ekuinox/mube/docs/superpowers/specs/2026-06-30-usb-power-5v3a-design.md

# #23 USB 電源を 5V/3A 化（M-12001 採用）設計

- Issue: #23 C2 5V/1A USB 電源がサーボ失速時に不足する可能性（親 #12）
- 日付: 2026-06-30
- 種別: ドキュメント変更のみ

## 背景

5V/1A の USB AC アダプタ（M-08312）では、サーボ失速時に電流が不足する恐れがある。

| 負荷 | 電流 |
| --- | --- |
| Pico W（WiFi active） | 100-200mA |
| SG90 サーボ（失速） | 650-700mA |
| LED（330R, 3.3V） | 4mA |
| 合計 | 約 900mA（1A に迫る） |

サムターンが固い場合や突入電流を考えると 1A では足りない。`docs/parts-selection.md` に代替として記載済みの 5V/3A（M-12001）へ切り替える。

## 変更範囲

`docs/parts-selection.md` のみ。`circuit/netlist.py`・ファーム・筐体は変更しない。AC アダプタとケーブルは基板部品ではなく netlist 管理外（メイン表の手配線品目）であり、netlist の PARTS/BOM には現れないため。

ビルド・テストへの影響なし。検証は表の金額合計・品目数の算術整合の目視確認のみ。

## 決定事項

- 案 A 採用: M-12001（Micro-B オス直結 5V/3A ¥1,100）をメイン表へ昇格。Micro-USB 端子へ直結できるため、micro-USB ケーブル（C-09314 ¥150）は不要となり BOM から削除する。
- 旧 5V/1A 品（M-08312）はメイン表・代替候補とも完全削除する。issue の結論が「1A は不足」と明確なため、候補に残さない。
- 「USB AC アダプタは 5V/1A 以上」の注意書きは「5V/3A 推奨（最低でも 5V/2A 以上）」へ更新する。

## 具体的な編集（`docs/parts-selection.md`）

1. 概要（範囲・購入先・在庫）の品目数を 17 → 16、手配線追加を 6 → 5、代替候補 4 → 3 に更新。
2. メイン表: USB 電源行を M-08312 → M-12001（¥1,100）へ置換。micro-USB ケーブル行（C-09314）を削除。
3. 概算サマリ:
   - ① 理論按分合計 ¥3,274 → ¥3,454
   - ② 実支出 ¥4,425 → ¥4,605
   - 内訳の秋月合計も ¥4,605 に更新
4. 購入先まとめ: M-08312 行を M-12001 行に差し替え、C-09314 行を削除。集約率 17/17 → 16/16。
5. 代替候補: M-12001 のエントリを削除（メイン昇格のため）。
6. 注意点:
   - 「USB AC アダプタは 5V/1A 以上」→「5V/3A 推奨（最低でも 5V/2A 以上）。サーボ失速電流 650-700mA に Pico W(WiFi) と LED を加えると 1A に迫るため」。
   - 「Pico W の USB コネクタは Micro-USB B。品目 14 のケーブルが対応していることを確認」→ M-12001 が Micro-B オス直結である旨に更新（ケーブルは無くなったため）。

## 金額の検算

新 ① = 1240+650+140+2+1+4+15+15+10+130+35+70+1100+12+10+20 = ¥3,454。
新 ② = 1240+650+140+150+100+180+150+15+10+130+350+70+1100+120+100+100 = ¥4,605。
旧との差分はいずれも -770-150+1100 = +180 で一致。

## 兄弟イシューとの兼ね合い

#21/#25/#26 は master（0a218c4）でマージ済みのため、本変更はその上に乗せる。同じ BOM 表を触る後続作業はない想定。
