ekuinox/mube/backlog/tasks/task-3 - detect-thumbturn-position-with-a-magnetic-sensor.md

---
id: TASK-3
title: サムターンの向き（施錠/解錠）を磁気センサーで取得する
status: To Do
assignee: []
created_date: '2026-07-20 09:44'
updated_date: '2026-07-20 09:58'
labels:
  - firmware
  - circuit
  - scad
dependencies: []
ordinal: 3000
---

## Description

<!-- SECTION:DESCRIPTION:BEGIN -->
サムターンの物理的な向き（施錠位置か解錠位置か）を実物のセンサーで取得する。現状のファームは指令値としての LockState しか持っておらず、実際にサムターンがどちらを向いているかは検知していない。位置センサーを足して、指令と実物のズレを解消する。方式の検討結果と評価候補パーツの記録。実装方式は実機評価で 1 つに確定させる前提で、まだ確定しない。（GitHub issue #67 から移管）

## 目的

- 手動操作の検知: 人が手でサムターンを回したことをファームが気づき、内部の状態を実物に追従させる。
- サーボ動作の確認: サーボが本当に施錠／解錠位置まで回りきったかを実測でフィードバックする（空振り・脱調の検知）。

連続角度は不要で、施錠／解錠の 2 値（＋どちらでもない中間）が分かれば十分。

## 方式

回転する側（サーボホーン／ソケット）に磁石を付け、動かない筐体側に磁気の位置センサーを置いて 2 値を読む。連続角度を取る AS5600 のようなロータリーエンコーダや、リニアホール＋ADC はオーバースペックのため見送る。

## 評価候補パーツ（秋月・両方買って実機比較する）

手はんだ前提で表面実装（SMD）は避ける、秋月で在庫がある、という制約で残った 2 つ。どちらもスルーホールで合計 350 円程度と安いので、ブレッドボードで両方組んで実測してから採用を決める。

| 素子 | 商品名 | 通販コード | 価格 | 構成 |
| --- | --- | --- | --- | --- |
| ホールラッチIC | SK1816G-G03（SIP-3, 交番検知, Bop +5mT / Brp -5mT） | I-11027 | 30円/個 | センサー1個＋逆向き磁石2個で1ビット取得 |
| リードスイッチ | MKA-10110（A接点, 無極性, ガラス管 φ1.8×10mm） | P-03676 | 290円/5個入 | センサー2個＋磁石1個 |

磁石は秋月に手頃な小型ネオジムの安定した商品が見当たらないため別調達（100均やモノタロウ等）。ラッチ式は感度しきい値 5mT が精密な代わりに極性と向きがシビア、リード式は当たりが広く極性・向き自由な代わりに動作点のバラつきが大きめ。動作ギャップはどちらも磁石の強さで決まり、数 mm のギャップなら両方とも届く見込み。

磁石の材質はネオジム必須ではない。ホールラッチのしきい値は 5mT と低く、リードも感度が良いため、100均のフェライト磁石でも数 mm の近距離なら反応する見込み。ネオジムの利点は同サイズで磁界が強くギャップを稼げる点にとどまる。材質より形と極の付き方が重要で、片面が N・反対面が S の固いボタン型／円盤／棒磁石なら可、冷蔵庫用のゴムシート型（多極着磁）は近距離で磁界が打ち消し合うため不可。ラッチ式で使う場合はどちらの面が N/S かの把握が必要（施錠位置に S 面・解錠位置に N 面の逆向き 2 個配置のため）。リード式は向き自由。まずは手持ちの磁石を実ギャップの距離で近づけてトリップするか確認するのが最短。

## 2方式の違いとトレードオフ

- ラッチ式（SK1816G ×1＋磁石2個）: 施錠位置に S 極、解錠位置に N 極を外向きに置き、固定した 1 個のセンサーで S極→ON・N極→OFF を読む。ソリッドステートで小型・精密・安価、GPIO 1 本で済む。欠点は、ラッチが最後に到達した位置を保持する仕組みのため「今まさに途中（半開き）」をリアルタイムに出せないことと、逆向き磁石 2 個の配置がシビアなこと。
- リード式（MKA-10110 ×2＋磁石1個）: 施錠角度と解錠角度にリードを 1 個ずつ置く。既存のタクトスイッチ SW1 と同じく片足を GPIO＋内部プルアップ、片足を GND に落とすだけで配線が最も単純。両方 OFF で中間（半開き）を明示的に検出でき、磁石は向き自由で 1 個。欠点はガラス管で割れやすく大きめ、接点のチャタリングにデバウンスが要ること（SW1 と同じ対処でよい）。

## 検討で見送ったもの（記録）

- ユニポーラ（非ラッチ）のホールIC S-5716ACDH0-M3T1U（I-16180）: 特性は理想的だが SOT23-3 の SMD で手はんだが厳しい。DIP 化変換基板でも SOT23 を付ける所が SMD 作業のままで解決しない。
- スルーホールのユニポーラ品 SK8552G-G03（I-11029）: 理想的だが入荷未定で在庫切れ。復活すれば有力候補。
- スルーホールのラッチ品 UH277G-G04（I-11031）や SK1816G を素直な 2 センサー方式で使うのは不可。ラッチは磁石が離れても OFF に戻らず、両方 ON で固まって区別できなくなる。ラッチは 1 センサー＋逆向き磁石 2 個の構成で使う。

## 実機で詰める未確定事項

- 磁石の種類・サイズと、ロータとセンサーのギャップ。
- センサー取付角度（施錠と解錠は約 90 度想定）と、施錠側と解錠側が互いに干渉しない離隔。
- GPIO 割当（暫定 GP19 / GP20）とデバウンス時定数。リード式は 2 本、ラッチ式は 1 本。
- 機構側の磁石マウントとセンサー座は採寸依存のため socket / mount_plate 側の未確定値として隔離する。

## 想定する影響範囲（実装時）

- circuit: `circuit/parts.ts` にセンサーとネットを追加、ERC とブレッドボード図を更新。
- mube-core: 物理位置の状態を追加し、指令 LockState と突き合わせて手回し検知とサーボ確認を行う。host テストを追加。
- firmware: 入力ピンをデバウンス付きで読む処理を追加（SW1 のボタン処理を流用）。
- プロトコル: STATUS 応答に物理位置を追加。
- scad: 磁石マウントとセンサー座（採寸確定後）。
<!-- SECTION:DESCRIPTION:END -->

## Acceptance Criteria
<!-- AC:BEGIN -->
- [ ] #1 実ギャップで確実にトリップ／リリースする
- [ ] #2 施錠位置と解錠位置を誤りなく区別できる（隣のセンサーや磁石の干渉がない）
- [ ] #3 手動操作の検知とサーボ到達の確認が意図通り動く
- [ ] #4 ラッチ式採用時、中間状態を出せない件が運用上問題ないことを確認
<!-- AC:END -->

## Implementation Notes

<!-- SECTION:NOTES:BEGIN -->
TASK-2（手回し操作後の施錠状態の再同期）を統合。位置センサーで実位置を取得できれば、手回し検知と内部状態の再同期はこのタスクの目的そのもの。
<!-- SECTION:NOTES:END -->
