ekuinox/mube/backlog/tasks/task-6 - top-heavy-mount-peels-off.md

---
id: TASK-6
title: 本体上部が重く固定が上から剥がれてくる
status: To Do
assignee: []
created_date: '2026-07-20 10:46'
labels:
  - scad
dependencies: []
ordinal: 6000
---

## Description

<!-- SECTION:DESCRIPTION:BEGIN -->
本体の上部が重く、ドアへ貼り付けた固定が上から剥がれてくる。現状の貼り付け（両面テープ想定）では、重心が高いぶんモーメントがかかって剥離しやすい。おそらくより強力な両面テープに替えても同じことが起こりうる。

検討したいこと:
- 重心を下げる（重量物＝サーボ／基板／電源の配置を下側へ寄せる、筐体の高さ・張り出しを減らす）
- 固定方法の見直し（貼り付け面積の拡大、ネジ／ブラケット併用、サムターン軸まわりでの支持）
- ドア側の受け構造で上方向の剥離モーメントを受け止める

関連: `scad/` の筐体レイアウトと取り付け方式。
<!-- SECTION:DESCRIPTION:END -->

## Acceptance Criteria
<!-- AC:BEGIN -->
- [ ] #1 重心を下げる／固定方法を見直して、上方向の剥離で外れないようにする
- [ ] #2 両面テープ以外も含めた固定方式の候補を比較検討する
<!-- AC:END -->
