ekuinox/mube/docs/parts-selection.md

# スマートロック パーツ選定（調達ドキュメント）

## 概要

- 目的: 回路記述（`circuit/index.tsx`、tscircuit）の部品を日本のネット通販で発注できる実商品へ対応づけ、購入先をまとめて 1 台分の概算を出す。
- 範囲: 完成実機に物理的に残る全 16 品目（BOM 11 点＋手配線に要る追加 5 点）。道具・消耗品は対象外。
- 購入先方針: 秋月電子通商に集約。全 16 品目が秋月で揃う。
- 調査日: 2026-06-25（価格・在庫・通販コードはこの時点のスナップショット。変動するため発注前に各店で要確認）。通販コードは各商品ページへのリンクになっている。
- 在庫・販売状況: 2026-06-25 時点で、メイン表 16 品目および備考の代替候補 3 品目すべてが秋月電子で販売中・在庫ありであることを商品ページで確認済み（廃盤なし）。一部は次回入荷待ちの表記があるが注文は可能。追加 3 品目（C2, D2, M2ネジ）は 2026-06-30 時点で在庫確認済み。USB 電源 M-12001 は 2026-06-30 時点で在庫確認済み。
- 数量: スマートロック 1 台分。パック品はパック価格と 1 台按分額を併記。

## メイン表

| Ref/品目 | 商品名 | 店 | 通販コード | 商品単価(税込) | 入数 | 1台必要数 | 1台按分額 |
|---|---|----|---|---|---|---|---|
| U1 Pico W | Raspberry Pi Pico W | 秋月 | [M-17947](https://akizukidenshi.com/catalog/g/g117947/) | ¥1,240 | 1 | 1 | ¥1,240 |
| M1 SG90 | マイクロサーボ9g SG90 | 秋月 | [M-08761](https://akizukidenshi.com/catalog/g/g108761/) | ¥650 | 1 | 1 | ¥650 |
| Q1 FET | NchパワーMOSFET 30V260A IRLB3813PBF | 秋月 | [I-06270](https://akizukidenshi.com/catalog/g/g106270/) | ¥140 | 1 | 1 | ¥140 |
| Rg 220Ω | カーボン抵抗(炭素皮膜抵抗) 1/4W220Ω | 秋月 | [R-25221](https://akizukidenshi.com/catalog/g/g125221/) | ¥150 | 100 | 1 | ¥2 |
| Rgs 10kΩ | カーボン抵抗(炭素皮膜抵抗) 1/4W10kΩ | 秋月 | [R-25103](https://akizukidenshi.com/catalog/g/g125103/) | ¥100 | 100 | 1 | ¥1 |
| Rled 330Ω | カーボン抵抗(炭素皮膜抵抗) 1/4W330Ω | 秋月 | [R-25331](https://akizukidenshi.com/catalog/g/g125331/) | ¥180 | 100 | 2 | ¥4 |
| D1 2色LED | 2色LED 赤・黄緑5mm カソードコモン 乳白色 OSRGHC5B32A（10個入） | 秋月 | [I-06314](https://akizukidenshi.com/catalog/g/g106314/) | ¥150 | 10 | 1 | ¥15 |
| SW1 押しボタン | パネル用押しボタンスイッチ モーメンタリー 丸型 白 PS21B-1 | 秋月 | [P-04583](https://akizukidenshi.com/catalog/g/g104583/) | ¥160 | 1 | 1 | ¥160 |
| C1 470µF | 電解コンデンサー 470µF16V105℃ ルビコンPX | 秋月 | [P-10273](https://akizukidenshi.com/catalog/g/g110273/) | ¥10 | 1 | 1 | ¥10 |
| - ユニバーサル基板 | 片面ガラスコンポジット・ユニバーサル基板 Cタイプ(72×47mm) めっき仕上げ | 秋月 | [P-03229](https://akizukidenshi.com/catalog/g/g103229/) | ¥130 | 1 | 1 | ¥130 |
| - 配線材 | 耐熱電子ワイヤー 1m×10色 導体外径0.36mm(AWG28相当) | 秋月 | [P-11640](https://akizukidenshi.com/catalog/g/g111640/) | ¥350 | 10 | 1 | ¥35 |
| - ピンヘッダ | ピンヘッダー 1×40 (40P) | 秋月 | [C-00167](https://akizukidenshi.com/catalog/g/g100167/) | ¥35 | 1 | 2 | ¥70 |
| - USB電源 | USB ACアダプター Micro-Bオス直結 5V3A | 秋月 | [M-12001](https://akizukidenshi.com/catalog/g/g112001/) | ¥1,100 | 1 | 1 | ¥1,100 |
| C2 100nF | 積層セラミックコンデンサー 0.1µF100V X7R 5mmピッチ | 秋月 | [P-15927](https://akizukidenshi.com/catalog/g/g115927/) | ¥120 | 10 | 1 | ¥12 |
| D2 1N5819 | ショットキーバリアダイオード 40V1A 1N5819 | 秋月 | [I-17244](https://akizukidenshi.com/catalog/g/g117244/) | ¥100 | 10 | 1 | ¥10 |
| - M2ネジ (サーボ固定) | なべ小ねじ(+) M2×5 黄銅 | 秋月 | [P-15887](https://akizukidenshi.com/catalog/g/g115887/) | ¥100 | 10 | 2 | ¥20 |

## 概算サマリ

- ① 1台分の理論按分合計: ¥3,599（按分額列の総和。理論上 1 台が消費する分だけの価値）
- ② 実際に 1 台作るために払う総額: ¥4,750（パック品も丸ごと買う前提の実支出。送料別）
  - 内訳: 秋月 ¥4,750（全点秋月、他店送りなし）
  - 送料の目安: 秋月電子は注文金額により変動。発注前に各店の送料条件を確認。
- 補足: ②は初回 1 台の実支出。抵抗等のパック余剰（各 99 本残）により 2 台目以降は①に近づく。

## 購入先まとめ

秋月電子通商で全点購入（集約率 16/16 = 100%）。他店送りなし。

| 店 | 通販コード | 品目 |
|----|---|---|
| 秋月電子通商 | [M-17947](https://akizukidenshi.com/catalog/g/g117947/) | Raspberry Pi Pico W |
| 秋月電子通商 | [M-08761](https://akizukidenshi.com/catalog/g/g108761/) | マイクロサーボ9g SG90 |
| 秋月電子通商 | [I-06270](https://akizukidenshi.com/catalog/g/g106270/) | NchパワーMOSFET IRLB3813PBF |
| 秋月電子通商 | [R-25221](https://akizukidenshi.com/catalog/g/g125221/) | カーボン抵抗 1/4W 220Ω（100本入） |
| 秋月電子通商 | [R-25103](https://akizukidenshi.com/catalog/g/g125103/) | カーボン抵抗 1/4W 10kΩ（100本入） |
| 秋月電子通商 | [R-25331](https://akizukidenshi.com/catalog/g/g125331/) | カーボン抵抗 1/4W 330Ω（100本入, 2本使用） |
| 秋月電子通商 | [I-06314](https://akizukidenshi.com/catalog/g/g106314/) | 2色LED 赤・黄緑 5mm カソードコモン 乳白色 OSRGHC5B32A（10個入） |
| 秋月電子通商 | [P-04583](https://akizukidenshi.com/catalog/g/g104583/) | パネル用押しボタンスイッチ モーメンタリー 丸型 白 PS21B-1 |
| 秋月電子通商 | [P-10273](https://akizukidenshi.com/catalog/g/g110273/) | 電解コンデンサー 470µF16V |
| 秋月電子通商 | [P-03229](https://akizukidenshi.com/catalog/g/g103229/) | 片面ユニバーサル基板 Cタイプ(72×47mm) めっき仕上げ |
| 秋月電子通商 | [P-11640](https://akizukidenshi.com/catalog/g/g111640/) | 耐熱電子ワイヤー 1m×10色 AWG28 |
| 秋月電子通商 | [C-00167](https://akizukidenshi.com/catalog/g/g100167/) | ピンヘッダー 1×40 ×2本 |
| 秋月電子通商 | [M-12001](https://akizukidenshi.com/catalog/g/g112001/) | USB ACアダプター Micro-Bオス直結 5V3A |
| 秋月電子通商 | [P-15927](https://akizukidenshi.com/catalog/g/g115927/) | 積層セラミックコンデンサー 0.1µF100V X7R 5mmピッチ（10個入, 1個使用） |
| 秋月電子通商 | [I-17244](https://akizukidenshi.com/catalog/g/g117244/) | ショットキーバリアダイオード 40V1A 1N5819（10本入, 1本使用） |
| 秋月電子通商 | [P-15887](https://akizukidenshi.com/catalog/g/g115887/) | なべ小ねじ(+) M2×5 黄銅（10個入, 2個使用） |

## 備考

### MOSFET の注意（重要）

第一候補の IRLZ44N は秋月取扱なしのため、採用品は IRLB3813PBF（秋月 I-06270, N-ch 30V/260A）。Q1 はサーボの GND リターン（SERVO_RTN）を切るローサイドスイッチで、ゲートは Pico W の GP14（3.3V）から Rg(220Ω) 経由で駆動し Rgs(10k) でプルダウン、給電時のみ ON のワンショット（約 500ms）。

**3.3V ゲート駆動の評価（現状維持の根拠, Issue #24）**

データシート実値（Infineon IRLB3813）: Vgs(th) min 1.35V / typ 1.9V / max 2.35V、Rds(on) @ Vgs=4.5V = 2.6mΩ(max)、@ Vgs=10V = 1.95mΩ(max)。3.3V GPIO で十分オンする直接的な根拠は Vgs(th) max 2.35V < 3.3V（GPIO 電圧が最悪閾値を上回る）であり、Rds(on) が Vgs=4.5V で規定されていることは本品がロジックレベル MOSFET であることの補強である。

- 十分にオンする: Vgs=3.3V のゲートオーバードライブは typ 閾値 1.9V に対し約 1.4V、最悪の閾値 max 2.35V でも約 0.95V。3.3V でエンハンスメント領域に入る。
- 電圧降下は無視できる: 3.3V は Rds(on) 規定点(4.5V)をわずかに下回るのみ。保守的に Rds(on) を Vgs=4.5V 時(2.6mΩ)の約 20 倍＝高々 50mΩ と見積もっても、SG90 の起動・失速ピーク（〜1A 程度）での降下は最悪約 50mV、実際は現実的な Rds(on)≒10mΩ 想定で 10mV 前後で、5V 供給に対し無視できる。
- 発熱も無視できる: ワンショット 500ms のため、ピーク電力は最悪でも P = I²·Rds(on) ≒ 1²×0.05 = 0.05W ≒ 50mW 程度、現実的な Rds(on)≒10mΩ 想定では約 10mW（1²×0.01）で問題にならない。

**実機ブリングアップ時の確認手順（受け入れ条件）**

1. サーボを動作させ、可能なら失速させてピーク電流を引かせる。
2. その状態で Q1 のドレイン-ソース間電圧 Vds を計測する。
3. 受け入れ基準: ピーク負荷で Vds ≤ 0.2V（5V 供給から実効サーボ電圧 ≥ 4.8V を確保、SG90 定格 4.8〜6V 内）。
4. 基準超過時: ロジックレベル品（Vgs(th) が低いスルーホール・秋月入手可の N-FET）への差し替え、または小信号トランジスタ等でゲートを 5V までスイングし Vgs≥4.5V を保証する 5V ゲート駆動の追加を検討する。

### 配線材

ジュンフロン線は秋月ネット通販で取扱なし。耐熱電子ワイヤー AWG28（[P-11640](https://akizukidenshi.com/catalog/g/g111640/)）で代替。手配線に十分。

### 代替候補

- Pico WH ヘッダ付き（[M-18086](https://akizukidenshi.com/catalog/g/g118086/) ¥1,375）: ピンヘッダ実装済みのため、ピンヘッダ（[C-00167](https://akizukidenshi.com/catalog/g/g100167/)）の購入が不要になる。
- 電解コンデンサ 25V 品（[P-17883](https://akizukidenshi.com/catalog/g/g117883/) ¥20）: 耐圧に余裕が欲しい場合の代替。
- ユニバーサル基板 eleshop UP-203GSR（[MA7128](https://eleshop.jp/shop/g/gMA7128/) ¥363, 両面, 既製四隅穴ピッチ 64×39）: 一度こちらへ変更したが（#68）、未使用のまま P-03229 に戻した。両面スルーホールが欲しい場合の代替。
- ユニバーサル基板 72×47.5mm（[P-00517](https://akizukidenshi.com/catalog/g/g100517/) ¥100）: 部品点数が増えた場合の代替。

### 注意点

- 二色LED（D1, OSRGHC5B32A）はコモンカソード。3 本足のうち共通カソード（K）を GND、赤アノード（R）を GP16、黄緑アノード（G）を GP18 へ。足の並びはデータシートで確認すること。赤・黄緑とも Vf=2.1V のため抵抗は両側 330Ω で明るさが揃う。施錠=赤・解錠=黄緑で点灯し、同時点灯はしない。
- 電解コンデンサ（C1）は極性あり。実装時に＋端子の向きを確認すること。耐圧 16V は VBUS 5V に対し十分な余裕がある。
- USB ACアダプタは 5V/3A 推奨（最低でも 5V/2A 以上）。サーボ失速電流 650-700mA に Pico W(WiFi) 100-200mA と LED を加えると 1A に迫り、5V/1A では突入・失速時に不足する恐れがあるため。
- Pico W の USB コネクタは Micro-USB B。採用した M-12001 は Micro-B オス直結なので、別途ケーブルなしで直接挿せる。
- セラミックコンデンサ（C2）は無極性。C1（電解 470µF）に並列で VBUS-GND 間に配置する。C1 に隣接させること（高周波バイパス効果のため）。
- ユニバーサル基板（P-03229）の既製の四隅マウント穴は φ3.2、中心間ピッチ 長辺66mm×短辺41mm。トレイはこの四隅穴に合わせた支柱 4 本で基板を受ける（M2 セルフタップ。φ3.2 に対しネジ山は効かず頭で押さえる）。
- ショットキーダイオード（D2, 1N5819）はカソード帯（白帯）を +5V 側（M1.V+）に、アノードを SERVO_RTN 側（M1.GND / Q1.D）に接続する。逆に付けるとサーボ電源が短絡するので極性に注意。
- M2 ネジ（なべ小ねじ M2×5）はサーボ耳のネジ穴 2 箇所に使用する。3D プリント筐体の 1.8mm パイロットホールにセルフタップで固定する。締めすぎるとボスが割れるので注意。
- SW1 は基板実装のタクトスイッチ（P-03647）からパネル取付の PS21B-1 へ変更した（2026-08-16）。カバー越しに押せるようにするため。実測値: ネジ部外径 φ11.5、フランジ φ18.7、パネル面より内側の奥行き 26mm。取付穴は φ12.0 で設計している。

### 回路記述（circuit/index.tsx）への申し送り TODO

実機で型番確定後に FET の value を 1 つへ絞り込み、コンデンサ耐圧を value に追記する。
