ekuinox/mube/docs/superpowers/specs/2026-06-30-bom-update-design.md

# BOM 3 品目追加 (closes #21, #25, #26)

## 背景

横断整合性レビュー (#12) で発見された以下 3 件を一括で対応する。

- #21 B6: M2 ネジが `parts-selection.md` の BOM に未記載
- #25 D1: セラミックバイパスコンデンサ (100nF) がない
- #26 D2: サーボモータにフライバックダイオードがない

## 追加部品

| 品目 | 商品名 | 通販コード | 単価(税込) | 入数 | 1台必要数 | 按分額 |
|---|---|---|---|---|---|---|
| - M2ネジ (サーボ固定) | なべ小ねじ(+) M2×5 (黄銅) | P-15887 | ¥100 | 10 | 2 | ¥20 |
| C2 100nF | 積層セラミックコンデンサー 0.1µF100V X7R 5mmピッチ | P-15927 | ¥120 | 10 | 1 | ¥12 |
| D2 1N5819 | ショットキーバリアダイオード 40V1A 1N5819 | I-17244 | ¥100 | 10 | 1 | ¥10 |

### M2 ネジの選定理由

Issue #21 は M2 x 6mm セルフタッピングを推奨しているが、秋月電子に M2 セルフタッピングの取扱がない。M2 x 5mm なべ小ねじ (黄銅, P-15887) を採用する。3D プリント樹脂の 1.8mm パイロットホール (params.scad `servo_screw_pilot`) に対して M2 (2.0mm) 機械ねじでセルフタップし、サーボタブ厚 2.5mm を通って残り 2.5mm のボス嵌合が得られる。軽負荷のサーボ固定には十分。秋月集約 100% を維持。

## 回路変更 (netlist.py)

### C2: 100nF セラミックバイパスコンデンサ

C1 (470µF 電解) に並列で VBUS-GND 間に接続。電解コンデンサは ESR/ESL が高く高周波ノイズの除去に不向きなため、セラミックコンデンサで補う。

### D2: 1N5819 フライバックダイオード

サーボモータ (M1) の V+ と GND 間に逆接続 (カソード→+5V, アノード→SERVO_RTN)。Q1 オフ時の逆起電力スパイクを +5V ラインにクランプする。

### 変更箇所

PARTS に追加:

```python
"C2": ["1", "2"],
"D2": ["A", "K"],
```

PART_META に追加:

```python
"C2": ("Ceramic cap", "100nF"),
"D2": ("Schottky diode", "1N5819"),
```

NETS (build_nets 内):

- `"+5V"`: 末尾に `("C2", "1"), ("D2", "K")` を追加
- `"GND"`: 末尾に `("C2", "2")` を追加
- `"SERVO_RTN"`: 末尾に `("D2", "A")` を追加

## parts-selection.md の更新

- メイン表に上記 3 行を追加
- 品目数: 14 → 17 (概要の内訳は BOM 9→11 点、追加 5→6 点。購入先まとめセクションも更新)
- 按分合計: ¥3,232 → ¥3,274 (+¥42)
- 実支出: ¥4,105 → ¥4,425 (+¥320)
- 購入先まとめ表に 3 行追加
- 備考セクションに M2 ネジ・C2・D2 の注意点を追記

## テスト

- `nix develop -c ./test/netlist_test.py` で ERC パス
- `nix develop -c cargo host-test` (Rust コード変更なしだが念のため)
