ekuinox/mube/docs/superpowers/plans/2026-06-25-parts-selection.md

# パーツ選定ドキュメント Implementation Plan

> **For agentic workers:** REQUIRED SUB-SKILL: Use superpowers:subagent-driven-development (recommended) or superpowers:executing-plans to implement this plan task-by-task. Steps use checkbox (`- [ ]`) syntax for tracking.

**Goal:** `circuit/netlist.py` の BOM を日本のネット通販（秋月電子に集約）で発注できる実商品へ写像し、購入先まとめと概算を載せた調達ドキュメント `docs/parts-selection.md` を作る。

**Architecture:** 1 本の Markdown を段階的に埋める。概要 → メイン表（コア9点＋追加5点）→ 按分計算と概算サマリ → 購入先まとめと備考、の順。価格・通販コードは Web リサーチで取得し、調査日を明記したスナップショットとして記録する。netlist.py は触らず参照のみ。

**Tech Stack:** Markdown のみ。リサーチに WebSearch / WebFetch。コード変更なし。

## Global Constraints

- 出力ファイルは単一の `docs/parts-selection.md`。netlist.py その他のソースは変更しない。
- 購入先は日本のネット通販サイトのみ。秋月電子通商（akizukidenshi.com）を主軸に集約し、秋月に無い／不適な品だけ千石電商・スイッチサイエンス等に回し、理由を明記する。
- 手配線前提でスルーホール品を優先（FET は TO-220 ロジックレベル、抵抗はリード品）。SMD は採らない。
- 数量はスマートロック 1 台分。パック品はパック価格（商品単価）と 1 台按分額の両方を載せる。
- 価格・通販コードは調査日時点のスナップショット。冒頭に調査日と価格変動・在庫の注意書きを置く。
- 仕様の正は `docs/superpowers/specs/2026-06-25-parts-selection-design.md`。対象14品目とルールはそこに従う。

---

### Task 1: ドキュメント骨子と概要セクション

**Files:**
- Create: `docs/parts-selection.md`

**Interfaces:**
- Consumes: spec `docs/superpowers/specs/2026-06-25-parts-selection-design.md`（範囲・方針）
- Produces: `docs/parts-selection.md` の見出し構成（`## 概要` / `## メイン表` / `## 概算サマリ` / `## 購入先まとめ` / `## 備考`）と、メイン表の空ヘッダ行。後続タスクはこの見出しに追記する。

- [ ] **Step 1: 骨子を書く**

`docs/parts-selection.md` を新規作成し、次の構成で枠を作る。

```markdown
# スマートロック パーツ選定（調達ドキュメント）

## 概要

- 目的: `circuit/netlist.py` の BOM を日本のネット通販で発注できる実商品へ対応づけ、購入先をまとめて 1 台分の概算を出す。
- 範囲: 完成実機に物理的に残る全 14 品目（BOM 9 点＋手配線に要る追加 5 点）。道具・消耗品は対象外。
- 購入先方針: 秋月電子通商に集約。無い／不適な品のみ他店（千石電商・スイッチサイエンス等）に回す。
- 調査日: <記入>（価格・在庫・通販コードはこの時点のスナップショット。変動するため発注前に各店で要確認）。
- 数量: スマートロック 1 台分。パック品はパック価格と 1 台按分額を併記。

## メイン表

| Ref/品目 | 商品名 | 店 | 通販コード | 商品単価(税込) | 入数 | 1台必要数 | 1台按分額 |
|----------|--------|----|-----------|---------------|------|-----------|-----------|

## 概算サマリ

## 購入先まとめ

## 備考
```

- [ ] **Step 2: 確認**

Run: `grep -nE '## (概要|メイン表|概算サマリ|購入先まとめ|備考)' docs/parts-selection.md`
Expected: 5 つの見出しが順に出る。

- [ ] **Step 3: コミット**

```bash
git add docs/parts-selection.md
git commit -m "docs: パーツ選定ドキュメントの骨子と概要を追加"
```

---

### Task 2: コア部品（BOM 9 点）の秋月リサーチとメイン表記入

**Files:**
- Modify: `docs/parts-selection.md`（メイン表に 9 行追記）

**Interfaces:**
- Consumes: Task 1 のメイン表ヘッダ。
- Produces: メイン表の 1〜9 行目（Ref U1/M1/Q1/Rg/Rgs/Rled/D1/SW1/C1 に対応）。各行に 商品名・店・通販コード・商品単価(税込)・入数 を埋める。按分額列は Task 4 で計算するため、この段階では空欄でよい。

リサーチ手順（各品目共通）: WebSearch / WebFetch で秋月電子通商（akizukidenshi.com）の商品ページを引き、商品名・通販コード（例 `M-12345` / `P-00112` / `R-25102` 形式）・税込価格・入数を記録する。選定はスペックの値・型の意図を満たすこと。秋月に適品が無い場合のみ千石電商・スイッチサイエンスを当たり、店名と通販コードを残す。調査日を控える。

各品目の検索キーワードと選定基準:

- U1 Raspberry Pi Pico W: 秋月で「Raspberry Pi Pico W」を検索。無線付き（W）であること。ヘッダ未実装の素の版を基準（ヘッダ付き版があれば備考に代替として記す）。
- M1 SG90 サーボ: 「SG90」または「サーボモーター SG90」。9g マイクロサーボ、3線。
- Q1 N-ch MOSFET（ロジックレベル）: 「IRLZ44N」を第一候補に検索。スルーホール TO-220、ロジックレベル（Vgs(th) が低く 3.3V GPIO で十分オンする）であること。IRLZ44N が無ければ同等のロジックレベル Nch TO-220（例 2SK4017 は閾値が高いので不可、代わりに RFP30N06LE 等）を探し、選んだ型番と理由を備考に残す。
- Rg 抵抗 220Ω: 「カーボン抵抗 1/4W 220Ω」。リード品。多くは 100 本入パック。入数を必ず記録。
- Rgs 抵抗 10kΩ: 「カーボン抵抗 1/4W 10kΩ」。同上。
- Rled 抵抗 330Ω: 「カーボン抵抗 1/4W 330Ω」。同上。
- D1 LED 5mm: 「5mm 赤色 LED」等。状態表示用。単品 or 小袋、入数を記録。
- SW1 タクトスイッチ: 「タクトスイッチ」。基板用、単品 or 小袋。
- C1 電解コンデンサ 470µF: 「電解コンデンサ 470µF」。耐圧は VBUS(5V) に余裕を持つ 10V 以上（16V/25V でも可）。

- [ ] **Step 1: 9 品目をリサーチしてメイン表に 9 行追記**

メイン表に各品目 1 行ずつ追記する（按分額列は空 `-`）。例（値は実リサーチで置換）:

```markdown
| U1 Pico W | Raspberry Pi Pico W | 秋月 | M-xxxxx | ¥x,xxx | 1 | 1 | - |
| M1 SG90 | SG90 マイクロサーボ | 秋月 | M-xxxxx | ¥xxx | 1 | 1 | - |
| Q1 FET | IRLZ44N (Nch ロジックレベル TO-220) | 秋月 | I-xxxxx | ¥xx | 1 | 1 | - |
| Rg 220Ω | カーボン抵抗 1/4W 220Ω | 秋月 | R-xxxxx | ¥xxx | 100 | 1 | - |
| Rgs 10kΩ | カーボン抵抗 1/4W 10kΩ | 秋月 | R-xxxxx | ¥xxx | 100 | 1 | - |
| Rled 330Ω | カーボン抵抗 1/4W 330Ω | 秋月 | R-xxxxx | ¥xxx | 100 | 1 | - |
| D1 LED | 5mm LED | 秋月 | I-xxxxx | ¥xx | 1 | 1 | - |
| SW1 | タクトスイッチ | 秋月 | P-xxxxx | ¥xx | 1 | 1 | - |
| C1 470µF | 電解コンデンサ 470µF/16V | 秋月 | P-xxxxx | ¥xx | 1 | 1 | - |
```

- [ ] **Step 2: 値・型の整合を確認**

確認（目視）: FET がロジックレベルのスルーホール品であること、コンデンサが 470µF かつ耐圧 10V 以上であること、抵抗 3 種の値が 220/10k/330Ω であること、各行に通販コードと税込価格が入っていること。

Run: `grep -nE 'xxxx|TBD|TODO|要調査' docs/parts-selection.md`
Expected: コア9行にプレースホルダが残っていない（マッチ無し、または追加品の未記入分のみ）。

- [ ] **Step 3: コミット**

```bash
git add docs/parts-selection.md
git commit -m "docs: コア部品(BOM 9点)を秋月の実商品にマッピング"
```

---

### Task 3: 追加部品（5 点）のリサーチとメイン表記入

**Files:**
- Modify: `docs/parts-selection.md`（メイン表に 5 行追記）

**Interfaces:**
- Consumes: Task 2 までのメイン表。
- Produces: メイン表の 10〜14 行目（ユニバーサル基板・配線材・ピンヘッダ・USB AC アダプタ・micro-USB ケーブル）。各行に 商品名・店・通販コード・商品単価(税込)・入数 を埋める。

各品目の検索キーワードと選定基準:

- ユニバーサル基板: 「ユニバーサル基板」。筐体内に収まる小型（例 47×36mm Type-C や 72×47mm）。サイズを商品名に残す。基板外形の筐体反映は対象外。
- 配線材: 「ジュンフロン線」または「スズメッキ線 ＋ 単線」。手配線用の細い線。1 台分は 1 巻で十分なので入数=1巻として按分は巻単位。
- ピンヘッダ: 「ピンヘッダ 40P」を基準（Pico W 実装用、必要なら折って 3P をサーボ接続に流用）。1 列ピンヘッダ。
- USB AC アダプタ（5V）: 「USB AC アダプタ 5V」。VBUS 給電源。秋月に無ければ千石/スイッチサイエンス/Amazon を当たり店名を残す。出力 5V・1A 以上。
- micro-USB ケーブル: 「micro USB ケーブル」。Pico W は micro-USB B。データ不要・給電できれば可。

- [ ] **Step 1: 5 品目をリサーチしてメイン表に 5 行追記**

```markdown
| - ユニバーサル基板 | ユニバーサル基板 <サイズ> | 秋月 | P-xxxxx | ¥xxx | 1 | 1 | - |
| - 配線材 | ジュンフロン線 <色/径> | 秋月 | P-xxxxx | ¥xxx | 1巻 | 1 | - |
| - ピンヘッダ | ピンヘッダ 1x40 (2.54mm) | 秋月 | C-xxxxx | ¥xx | 1 | 1 | - |
| - USB電源 | USB AC アダプタ 5V/1A | <店> | <コード> | ¥xxx | 1 | 1 | - |
| - USBケーブル | micro-USB ケーブル | <店> | <コード> | ¥xxx | 1 | 1 | - |
```

- [ ] **Step 2: 確認**

確認（目視）: 5 品目すべてに店・通販コード・税込価格が入っていること。他店に回した品があれば店名が秋月以外で残っていること。

Run: `grep -nE 'xxxx|<サイズ>|<色|<店>|<コード>|TBD|TODO|要調査' docs/parts-selection.md`
Expected: マッチ無し（全プレースホルダが実値に置換済み）。

- [ ] **Step 3: コミット**

```bash
git add docs/parts-selection.md
git commit -m "docs: 追加部品(基板/配線材/ピンヘッダ/USB電源/ケーブル)を選定"
```

---

### Task 4: 按分額の計算と概算サマリ

**Files:**
- Modify: `docs/parts-selection.md`（メイン表の按分額列を全行埋め、概算サマリを記述）

**Interfaces:**
- Consumes: Task 2・3 で埋めた全 14 行の 商品単価・入数・1台必要数。
- Produces: 各行の `1台按分額`（= 商品単価 ÷ 入数 × 1台必要数、円未満切り上げ）と、概算サマリの 2 値（①理論按分合計 ②実支出総額）。

- [ ] **Step 1: 按分額列を全 14 行ぶん計算して埋める**

各行 `1台按分額 = ceil(商品単価 ÷ 入数 × 1台必要数)`。例: 100 本入 ¥100 の抵抗を 1 本 → ¥1。Pico W のような入数 1 の単品は商品単価そのまま。

- [ ] **Step 2: 概算サマリを書く**

`## 概算サマリ` に次の 2 値と内訳を書く。

```markdown
- ① 1台分の理論按分合計: ¥xxx（按分額列の総和。理論上 1 台が消費する分だけの価値）
- ② 実際に 1 台作るために払う総額: ¥x,xxx（パック品も丸ごと買う前提の実支出。送料別）
  - 内訳: 秋月 ¥x,xxx ＋ 他店 ¥xxx
  - 送料の目安: 秋月（注文金額により変動）、他店分は別途。発注前に各店の送料条件を確認。
- 補足: ②は初回 1 台の実支出。抵抗等のパック余剰により 2 台目以降は①に近づく。
```

- [ ] **Step 3: 確認**

確認（目視＋暗算）: 按分額列に空 `-` が無いこと。①が按分額列の総和に一致すること。②が「各商品単価 × 必要購入数」の合計に一致すること。

Run: `grep -nE '\| *- *\|' docs/parts-selection.md`
Expected: 按分額列に `-` の残りが無い（ヘッダ区切り行を除く）。

- [ ] **Step 4: コミット**

```bash
git add docs/parts-selection.md
git commit -m "docs: 按分額の計算と概算サマリ(理論按分/実支出)を追加"
```

---

### Task 5: 購入先まとめ・備考・最終検証

**Files:**
- Modify: `docs/parts-selection.md`（購入先まとめ・備考を記述、調査日を確定）

**Interfaces:**
- Consumes: 全 14 行のメイン表と概算サマリ。
- Produces: 店ごとの購入グループ、秋月集約率、備考（他店送りの理由・代替候補・netlist 申し送り TODO）、確定した調査日。これで完了条件を満たす。

- [ ] **Step 1: 購入先まとめを書く**

```markdown
- 秋月電子通商で買うもの（n 点）: <品目リスト>
- 他店で買うもの: <店名と品目、無ければ「なし（全点秋月）」>
- 秋月集約率: n/14 点
```

- [ ] **Step 2: 備考を書く**

次を含める。
- 他店に回した品目があればその理由（秋月に在庫・適品が無い等）。
- 主要部品の代替候補（例 Pico W ヘッダ付き版、FET 代替型番）。
- 注意点（電解コンの極性・耐圧、配線材の太さ、USB アダプタの出力）。
- netlist.py への申し送り TODO: 実機で型番確定後に FET の `value` を 1 つへ絞り込み、コンデンサ耐圧を `value` に追記する（本作業では netlist.py は変更しない）。

- [ ] **Step 3: 調査日を確定する**

`## 概要` の `調査日: <記入>` を、リサーチを行った実日付に置換する。

- [ ] **Step 4: 完了条件の最終チェック**

確認（spec セクション 5 の完了条件と突き合わせ）:
- 全 14 品目が実商品に対応づき、商品名・店・通販コード・商品単価が埋まっている。
- FET がロジックレベルのスルーホール品、コンデンサが 470µF かつ耐圧 10V 以上。
- 秋月集約率が記載され、他店送りには理由がある。
- 概算サマリに①理論按分合計と②実支出総額の両方がある。
- 冒頭に調査日と価格スナップショットの注意書きがある。

Run: `grep -nE 'xxxx|TBD|TODO（未|要調査|<記入>|<店>|<コード>|<品目|<サイズ>' docs/parts-selection.md`
Expected: マッチ無し（申し送りの「TODO」記述は文章として残ってよいが、未記入を示すプレースホルダは無いこと）。

- [ ] **Step 5: コミット**

```bash
git add docs/parts-selection.md
git commit -m "docs: 購入先まとめ・備考・調査日を確定しドキュメント完成"
```

---

## 完了の定義

- `docs/parts-selection.md` が全 14 品目を秋月集約で実商品にマッピングし、通販コード・商品単価・入数・1台必要数・按分額を持つ。
- 概算サマリが理論按分合計と実支出総額の両方を示す。
- 購入先まとめ（集約率）と備考（他店理由・代替・netlist 申し送り）がある。
- spec `2026-06-25-parts-selection-design.md` の完了条件をすべて満たす。
