ekuinox/mube/docs/superpowers/specs/2026-06-25-parts-selection-design.md

# パーツ選定ドキュメント 設計仕様

- 日付: 2026-06-25
- ステータス: 確定
- 対象: スマートロックの電装を、日本のネット通販で発注できる実商品へ落とし込み、購入先をまとめて概算を出す調達ドキュメントを作る
- 関連: `2026-06-24-pcb-netlist-as-code-design.md`（電気設計・BOM の真実の単一ソース `circuit/netlist.py`）

## 1. スコープ

- **作るもの**:
  - パーツ選定ドキュメント1本（`docs/parts-selection.md` を想定。最終パスは実装フェーズで確定）。
  - `circuit/netlist.py` の BOM を「秋月電子で実際に発注できる商品」へ対応づけたメイン表。
  - 1台あたりの概算（理論按分合計と、パック丸ごと購入の実支出総額の両方）。
  - 購入先まとめ（店ごとのグルーピング）。
- **作らないもの（非目標）**:
  - 道具・消耗品（はんだごて・はんだ・工具類）の選定。成果物（完成実機）に残らないため対象外。
  - 回路設計そのものの変更（BOM は `netlist.py` を正とする。本ドキュメントは選定のみ。netlist.py は今回触らない）。
  - netlist.py への型番フィードバック（追加5点は回路素子でないため netlist に載せない。FET 型番の絞り込み・コンデンサ耐圧の追記は、実機で確定後に行う申し送りとして備考に残す。本作業では実施しない）。
  - 実発注・在庫の自動追跡。価格・在庫はスナップショットとして記録する。
  - 基板外形・部品配置の筐体（OpenSCAD）への反映（`pcb-netlist-as-code` 仕様どおり対象外）。

### 設計判断
- BOM はすでに `circuit/netlist.py` に確定済みなので、本作業は「型番→実商品」への写像と価格付けに集中する。回路の善し悪しは蒸し返さない。
- 「成果物に物理的に残るもの」を範囲とする。完成したスマートロックの中に入る物（基板・配線材・ピンヘッダ・給電源を含む）は載せ、組立中にしか使わない道具は載せない。

## 2. 選定対象の品目

`netlist.py` の BOM 9 点に、手配線で実機を組むのに必要で、かつ完成実機に残る追加 5 点を加えた計 14 品目を対象とする。

| # | 区分 | 品目 | 選定上の前提 |
|---|---|---|---|
| 1 | BOM | Raspberry Pi Pico W | ヘッダ未実装の素の版を基準（手配線で直付け or ピンヘッダ実装） |
| 2 | BOM | SG90 サーボ | 3線・付属コネクタあり |
| 3 | BOM | N-ch MOSFET（ロジックレベル） | 手配線前提でスルーホール品（TO-220、例 IRLZ44N）を優先。SMD の AO3400 は手配線に不向きなため非優先 |
| 4 | BOM | 抵抗 220Ω | リード品。多くはパック（例 100 本入）単位 |
| 5 | BOM | 抵抗 10kΩ | 同上 |
| 6 | BOM | 抵抗 330Ω | 同上 |
| 7 | BOM | LED 5mm | 単品 or 小袋 |
| 8 | BOM | タクトスイッチ | 単品 or 小袋 |
| 9 | BOM | 電解コンデンサ 470µF | 単品。耐圧は VBUS(5V) に対し余裕を持つ（例 10V 以上） |
| 10 | 追加 | ユニバーサル基板 | 筐体内に収まる小型。基板外形の筐体反映は対象外 |
| 11 | 追加 | 配線材 | ジュンフロン線/スズメッキ線等、手配線用 |
| 12 | 追加 | ピンヘッダ | Pico W 実装用（40P）＋サーボ接続用（3P） |
| 13 | 追加 | USB AC アダプタ（5V） | VBUS 給電源 |
| 14 | 追加 | micro-USB ケーブル | Pico W は micro-USB B コネクタ |

## 3. 選定ルール

1. **集約**: 秋月電子通商を主軸とし、ほぼ全点を 1 店で揃える。秋月に無い／適切な品が無い物だけ他店（千石電商・スイッチサイエンス等）に回し、回した物は理由を明記する。各店ともネット通販を持つ国内サイトであること。
2. **手配線最適**: スルーホール品を優先する（FET は TO-220、抵抗はリード品）。SMD は採らない。
3. **電気的整合**: 値・耐圧・極性などは `netlist.py` の意図（ロジックレベル FET、470µF バルクコン等）を満たす商品を選ぶ。
4. **数量**: スマートロック 1 台分の必要数で計算する。パック品はパック単位の購入単価を載せ、1 台あたりの按分額も併記する。
5. **スナップショット明記**: 価格・通販コードは調査日時点の値であることをドキュメント冒頭に明記し、価格変動・在庫切れの注意書きを置く。

## 4. ドキュメント構成と表スキーマ

1. **概要**: 目的・範囲・調査日・購入先方針・価格スナップショットの注意書き。
2. **メイン表**: 1 行 1 品目。

   | 列 | 内容 |
   |----|------|
   | Ref/品目 | `netlist.py` の Ref（追加品は「-」）と品目名 |
   | 商品名 | 実際に買う商品の名称 |
   | 店 | 秋月 / 千石 / スイッチサイエンス 等 |
   | 通販コード | 各店の商品コード（発注時の同定用） |
   | 商品単価 | その商品の購入単価（パック品はパック価格） |
   | 入数 | 1 商品あたりの個数（単品は 1） |
   | 1台必要数 | 1 台組むのに使う個数 |
   | 1台按分額 | 商品単価 ÷ 入数 × 1台必要数 |

3. **概算サマリ**: 次の 2 値を提示する。
   - ① 1台分の理論按分合計（按分額の総和）。
   - ② 実際に 1 台作るために払う総額（パック品も丸ごと買う前提の実支出。送料は別記）。
4. **購入先まとめ**: 店ごとに買う物をグルーピングし、カゴ投入しやすい形にする。秋月集約率（全品中の秋月点数）も示す。
5. **備考**: 他店送りの理由、代替候補、注意点（耐圧・極性・在庫変動など）。あわせて netlist.py への申し送り（実機確定後に FET 型番を 1 つへ絞り込み／コンデンサ耐圧を `value` に追記）を将来 TODO として記す。

## 5. 検証観点（完了条件）

- 全 14 品目が実商品に対応づき、商品名・店・通販コード・商品単価が埋まっている。
- 各 BOM 品が `netlist.py` の値・型の意図を満たしている（FET はロジックレベルのスルーホール品、コンデンサは 470µF 等）。
- 秋月集約率が分かり、他店送りの品目には理由が添えてある。
- 概算サマリに①理論按分合計と②実支出総額の両方が出ている。
- 冒頭に調査日と価格スナップショットの注意書きがある。
