ekuinox/mube/enclosure/models/clash_check.scad

// 部品間の体積干渉チェック用モデル。組立位置に置いた部品ペアの intersection を並べる。
// 干渉が無ければ全ペアが空になり、トップレベルは空（clash.ts が「empty」ログで PASS 判定）。
// 形状が出力された場合は干渉あり＝FAIL。
// 注意: 「空出力が正解」という逆セマンティクスなので render.sh / CI の汎用レンダリング
// ループでは回さないこと（空を FAIL 扱いされる）。判定は必ず clash.ts 経由で行う。
//
// 載せる側の部品は組立位置から clash_eps だけ +Z に浮かせる。意図的な面接触（トレイ床/
// フランジ底 vs プレート上面、ボス上面 vs ファンネル始端、カバー耳下面 vs プレート上面、
// カバー側ボス上面 vs カバー側ファンネル始端、カバー裾 vs 外周リブ）は体積ゼロだが、
// intersection が縮退シェルとして面を出してしまい偽陽性になるため。clash_eps 以下の
// 浅い食い込みや体積がほぼゼロの極薄スライバは検出できない代償があるが、実害レベルの
// 食い込みは検出できる。
include <params.scad>
use <body.scad>
use <tray.scad>
use <pedestal.scad>
use <cover.scad>

clash_eps = 0.05;

// body × tray（トレイは組立位置 z=wall + 浮かせ）
intersection() {
  body();
  translate([0, 0, wall + clash_eps]) tray();
}

// body × pedestal（ペデスタルは組立位置 z=wall + 浮かせ）
intersection() {
  body();
  translate([0, 0, wall + clash_eps]) pedestal();
}

// tray × pedestal（どちらも組立位置。同一平面同士なので浮かせ不要＝相対位置は組立通り）
intersection() {
  translate([0, 0, wall]) tray();
  translate([0, 0, wall]) pedestal();
}

// cover × body（カバーを浮かせる）
intersection() {
  body();
  translate([0, 0, clash_eps]) cover();
}

// cover × tray（どちらも組立位置。トレイは z=wall へ）
intersection() {
  translate([0, 0, wall]) tray();
  translate([0, 0, clash_eps]) cover();
}

// cover × pedestal
intersection() {
  translate([0, 0, wall]) pedestal();
  translate([0, 0, clash_eps]) cover();
}
