ekuinox/mube/enclosure/models/pedestal_test.scad

include <params.scad>
use <pedestal.scad>
pedestal();
echo("pedestal_test ok");
