ekuinox/mube/(list of files, cad)

Other CAD files:
enclosure/models/hardware.scad
enclosure/models/pedestal.scad
enclosure/models/smoke.scad
enclosure/models/tray.scad
enclosure/models/tray_pilot_gauge.scad
enclosure/models/hardware_test.scad
enclosure/models/params_test.scad
enclosure/models/socket_test.scad
enclosure/models/tray_test.scad
test/clash_check.scad
test/hardware_test.scad
test/params_test.scad
test/socket_test.scad
