ekuinox/mube/backlog/tasks/task-7 - manual-unlock-clutch-and-exposed-thumbturn.md

---
id: TASK-7
title: '手動解錠が重い: サーボ切り離し機構とサムターン露出の検討'
status: To Do
assignee: []
created_date: '2026-07-20 10:46'
labels:
  - firmware
dependencies: []
ordinal: 7000
---

## Description

<!-- SECTION:DESCRIPTION:BEGIN -->
サーボへの給電を止めきれておらず（GP14 の電源ゲートで動作時のみ ON にしているはずだが実際には抵抗が残る）、手動でサムターンを回して解錠しようとすると、サーボのギアが抵抗になって重い。

方針の候補:
- サーボとサムターンを常時直結せず、クラッチ／切り離し機構を入れて手動操作時はサーボを切り離す。参考: https://dreamerdream.hateblo.jp/entry/2022/09/22/180000
- サムターン自体は露出させる方向で設計を見直す（手で直接回せるようにする）。
- 給電カットが本当に効いているか（電源ゲートの実挙動、無給電時のサーボの逆駆動トルク）を実機で確認する。

関連: 電源ゲートは `crates/firmware/`、機構・露出設計は `scad/`。TASK-1（省電力）とは別で、こちらは「手動操作時の機構的な重さ」の解消が目的。
<!-- SECTION:DESCRIPTION:END -->

## Acceptance Criteria
<!-- AC:BEGIN -->
- [ ] #1 手動でサムターンを回したときサーボのギア抵抗で重くならないようにする
- [ ] #2 クラッチ/切り離し機構またはサムターン露出のいずれかの方式を決める
- [ ] #3 無給電時のサーボ逆駆動トルクと電源ゲートの実挙動を実機で確認する
<!-- AC:END -->
