ekuinox/mube/docs/measurements-checklist.md

# 実測チェックリスト（サーボ勘合・ドア固定）

> 状態（2026-07-20）: サーボ系（A）もドア系（B）も実測済みで、`params.scad` に反映済み。
> このチェックリストは実測記録のアーカイブとして残す。新たな未実測寸法が出たらここに追記する。

## 目的

`enclosure/models/params.scad` で「要実測／概算／仮値」になっている寸法を実機・実ドアで確定するためのチェックリスト。測定後にこの表の「実測値」を埋め、その値で `params.scad` を更新する。

## 使い方

1. ノギス（デジタルキャリパー）で各項目を測る。
2. 「実測値」欄に記入し、チェックを付ける。
3. 対応する `params.scad` の変数を実測値へ更新する。
4. `just enclosure`（`bun enclosure/scripts/build.ts`）で再レンダし、試しプリントで実フィットを確認する。

測定タイミング:
- A. サーボ系は現物（SG90）が届いてから。
- B. ドア系はいつでも測れる。

## A. SG90 サーボ実測（現物が届いてから）

ホーン系（`horn_*`）はソケットのホーンポケット勘合そのもの。タブ厚・ネジ間隔は #52（耳ボスの噛み合い）の再設計に必要。

方針: サーボ本体・タブ・軸・ネジ間隔は公称値を採用（測定不要）。実測が要るのは付属十字ホーンのみ。

| 済 | 測定項目 | 対応 params | 現在値 | 実測値 |
|----|---|---|---|---|
| [x] | 十字ホーン 腕の長さ（中心→腕先端） | `horn_arm_l` | 16.1 | 15.7 |
| [x] | 十字ホーン 腕の幅（見下ろし方向） | `horn_arm_w` | 2 | 6.2 |
| [x] | 十字ホーン 中央ハブ外径 | `horn_hub_d` | 7 | 7.3 |
| [x] | 十字ホーン 厚み（Z方向） | `horn_thick` | 2 | 1.7 |
| [x] | 十字ホーン 中心ネジ穴径 | `horn_screw_d` | 2.2 | 1.5 |
| 公称 | 耳（マウントタブ）ネジ穴 中心間距離 | `servo_screw_span` | 27.6 | 公称採用 |
| 公称 | タブ厚 ※#52 に直結 | `servo_tab_h` | 2.5 | 公称採用 |
| 公称 | タブ全長（両耳の外〜外） | `servo_tab_l` | 32.2 | 公称採用 |
| 公称 | 出力軸ボス径 | `servo_shaft_d` | 4.8 | 公称採用 |
| 公称 | 本体長さ | `servo_body_l` | 22.8 | 公称採用 |
| 公称 | 本体幅 | `servo_body_w` | 12.2 | 公称採用 |
| 公称 | 本体高さ | `servo_body_h` | 22.5 | 公称採用 |

## B. ドアのサムターン＆周辺実測（いつでも可）

ノブ系はソケットのノブ掴み側の勘合。`clear_left` / `clear_down` / `rosette_d` は筐体が干渉せず収まるかの制約（`params.scad` の assert がここを見ている）。

| 済 | 測定項目 | 対応 params | 現在値(仮) | 実測値 |
|----|---|---|---|---|
| [x] | ノブ 根元幅（ドア側・広い方） | `knob_w_base` | 28 | 27.8 |
| [x] | ノブ 先端幅（狭い方） | `knob_w_top` | 25 | 25.6 |
| [x] | ノブ 厚み | `knob_t` | 3 | 3.1 |
| [x] | ノブ 突き出し高さ（ドア面→先端） | `knob_h` | 11 | 30 |
| [x] | ソケットで掴む深さ（`knob_h` 未満で決める） | `knob_engage` | 10 | 10 |
| [x] | 座（ロゼット）外径 | `rosette_d` | 46 | 45 |
| [x] | 軸中心→ドア枠/端 の余裕（−X） | `clear_left` | 30 | 50 未満 |
| [x] | 軸中心→ドアレバー/ハンドル の余裕（−Y） | `clear_down` | 40 | 65 未満 |

## C. ネジ（実測不要）

M2×5（黄銅, 秋月 P-15887）は規格標準品なので実測は不要。呼び径 2.0mm / 長さ 5mm で確定。

| 項目 | 対応 params | 値 | 扱い |
|---|---|----|---|
| M2 呼び径・長さ | — | M2×5 | 標準品採用（目視照合のみ） |
| ボス下穴径 | `servo_screw_pilot` | 1.8 | 公称のまま。試しプリントで食いつきを見て微調整（緩ければ 1.6〜1.7） |

ネジの食い代（噛み合い深さ）の不足は #52 で別途対応。ネジ寸法ではなくボス形状の設計問題。

## 実測後の流れ

1. 上記の値で `enclosure/models/params.scad` を更新。
2. #52（耳ボスの実効噛み合い ~1.6mm）をタブ厚の実測値を踏まえて設計解決。
3. `just enclosure`（`bun enclosure/scripts/build.ts`）で全パート再レンダ（`Status: NoError` 確認）。
4. 試しプリント → サーボ↔ソケット、サーボ↔筐体の実フィット確認。
