ekuinox/mube/docs/superpowers/plans/2026-06-28-issue13-ci.md

# Issue #13 修正 + CI 導入 実装計画

> **For agentic workers:** REQUIRED SUB-SKILL: Use superpowers:subagent-driven-development (recommended) or superpowers:executing-plans to implement this plan task-by-task. Steps use checkbox (`- [ ]`) syntax for tracking.

**Goal:** spawner.spawn() の括弧位置バグを修正し、GitHub Actions CI (check/clippy/test) で再発を防ぐ

**Architecture:** main.rs の3行を機械的に修正した上で、`.github/workflows/ci.yml` を新規作成する。CI は `dtolnay/rust-toolchain` action で Rust をセットアップし、smtlk-core はホストターゲットで check/clippy/test、firmware はダミー CYW43 ブロブを置いて check/clippy を実行する。

**Tech Stack:** GitHub Actions, Rust (stable), cargo check/clippy/test

## Global Constraints

- `nix develop -c` 経由で cargo を実行すること（ローカル。CI は rustup 直接）
- `Cargo.lock` はコミット済み。CI でも `--locked` を付ける
- CYW43 ブロブ (`.bin`) は gitignore 済み。CI ではダミー空ファイルで代用
- CLAUDE.md に追記済みのルール: Rust コード変更後はコミット前に `nix develop -c cargo host-test` を通す

---

### Task 1: spawner.spawn() の括弧位置修正

**Files:**
- Modify: `crates/firmware/src/main.rs:100,127,144`

**Interfaces:**
- Consumes: なし
- Produces: なし（既存コードの修正のみ）

- [ ] **Step 1: 3箇所の括弧位置を修正**

100行目:
```rust
// before
spawner.spawn(servo_task(servo).unwrap());
// after
spawner.spawn(servo_task(servo)).unwrap();
```

127行目:
```rust
// before
spawner.spawn(cyw43_task(runner).unwrap());
// after
spawner.spawn(cyw43_task(runner)).unwrap();
```

144行目:
```rust
// before
spawner.spawn(net_task(net_runner).unwrap());
// after
spawner.spawn(net_task(net_runner)).unwrap();
```

- [ ] **Step 2: host テストが壊れていないことを確認**

Run: `nix develop -c cargo host-test`

Expected: 既存テストが全て PASS（smtlk-core のテストのみ実行される。firmware は thumbv6m ターゲット専用 + CYW43 ブロブ未配置のためホストテスト対象外）

- [ ] **Step 3: コミット**

```bash
git add crates/firmware/src/main.rs
git commit -m "fix: spawner.spawn() の括弧位置を修正 (closes #13)"
```

---

### Task 2: GitHub Actions CI ワークフロー作成

**Files:**
- Create: `.github/workflows/ci.yml`

**Interfaces:**
- Consumes: Task 1 の修正済み main.rs（CI で check が通ることの前提）
- Produces: なし

- [ ] **Step 1: `.github/workflows/ci.yml` を作成**

```yaml
name: CI

on:
  push:
    branches: [master]
  pull_request:
    branches: [master]

env:
  CARGO_TERM_COLOR: always

jobs:
  check:
    runs-on: ubuntu-latest
    steps:
      - uses: actions/checkout@v4

      - uses: dtolnay/rust-toolchain@stable
        with:
          targets: thumbv6m-none-eabi
          components: clippy

      - name: Create dummy CYW43 firmware blobs
        run: |
          mkdir -p crates/firmware/cyw43-firmware
          touch crates/firmware/cyw43-firmware/43439A0.bin
          touch crates/firmware/cyw43-firmware/43439A0_clm.bin

      - name: cargo check (smtlk-core)
        run: cargo check -p smtlk-core --locked --target x86_64-unknown-linux-gnu

      - name: cargo check (smtlk-firmware)
        run: cargo check -p smtlk-firmware --locked --target thumbv6m-none-eabi

      - name: cargo clippy (smtlk-core)
        run: cargo clippy -p smtlk-core --locked --target x86_64-unknown-linux-gnu -- -D warnings

      - name: cargo clippy (smtlk-firmware)
        run: cargo clippy -p smtlk-firmware --locked --target thumbv6m-none-eabi -- -D warnings

      - name: cargo test (smtlk-core)
        run: cargo test -p smtlk-core --locked --target x86_64-unknown-linux-gnu
```

- [ ] **Step 2: コミット**

```bash
git add .github/workflows/ci.yml
git commit -m "ci: cargo check/clippy/test の GitHub Actions ワークフローを追加"
```

---

### Task 3: CLAUDE.md ルール追記のコミット

**Files:**
- Modify: `CLAUDE.md` (既に変更済み)

**Interfaces:**
- Consumes: なし
- Produces: なし

- [ ] **Step 1: 変更内容を確認**

Run: `git diff CLAUDE.md`

Expected: 「触る時の注意」セクション先頭に `Rust コードを変更したらコミット前に nix develop -c cargo host-test を通すこと。テストが落ちたまま完了扱いにしない。` が追加されている

- [ ] **Step 2: コミット**

```bash
git add CLAUDE.md
git commit -m "docs: CLAUDE.md にローカルテスト実行ルールを追記"
```
