ekuinox/mube/crates/mube-firmware/src/config.rs

//! 接続設定。ビルド時に環境変数 `WIFI_SSID` / `WIFI_PASSWORD` から埋め込む。
//!
//!     WIFI_SSID=... WIFI_PASSWORD=... nix develop -c cargo build --release --locked
//!
//! 未設定のときはプレースホルダにフォールバックする（ビルドは通るが実機では
//! WiFi に接続できない）。実値をソースやコミットに書かないこと。
//! rustc は `option_env!` の参照を dep-info に記録するため、環境変数の値を
//! 変えれば再ビルドされる。

pub const WIFI_SSID: &str = match option_env!("WIFI_SSID") {
    Some(v) => v,
    None => "YOUR_WIFI_SSID",
};

pub const WIFI_PASSWORD: &str = match option_env!("WIFI_PASSWORD") {
    Some(v) => v,
    None => "YOUR_WIFI_PASSWORD",
};

/// SSID / パスワードの両方がビルド時 env から与えられたか。
/// false（プレースホルダのまま）だと join は永久に失敗するので、起動時に警告する。
pub const WIFI_CONFIGURED: bool =
    option_env!("WIFI_SSID").is_some() && option_env!("WIFI_PASSWORD").is_some();

use embassy_time::Duration;

/// 解錠してから自動で施錠するまでの待ち時間。
/// ここを変えればオートロックの間隔を調整できる。`Duration::from_secs` は
/// const fn なので const 定数として置ける。0 に近い値は解錠直後に即施錠して
/// しまうので避けること。
pub const AUTO_LOCK_AFTER: Duration = Duration::from_secs(60);
