ekuinox/mube/(commit log)

2026-06-24 docs: smart lock enclosure spec and implementation plan
2026-06-24 chore: scaffold Nix dev env and headless OpenSCAD render test harness
    [smoke.scad]
2026-06-24 feat: parametric dimensions in params.scad with sanity asserts
    [params.scad, params_test.scad]
2026-06-24 feat: hardware reference cutouts and mounts in hardware.scad
    Add hardware.scad with six modules for reference geometry:
    - sg90_cutout(): servo body + mounting tabs + shaft clearance
    - pico_w_mounts(): four standoff bosses with pilot holes
    - usb_cutout(): USB plug opening
    - led_hole(): LED through-hole
    - button_hole(): tactile button panel hole
    - mosfet_space(): MOSFET keep-out box
    Add test/hardware_test.scad that instantiates all modules
    to verify they compile and render manifold geometry.
    [hardware.scad, hardware_test.scad]
2026-06-24 feat: parametric thumb-turn socket in socket.scad
    Implements thumbturn_socket() module with knob pocket on top (+Z),
    servo shaft bore on bottom (-Z), and parametric sizing based on
    knob dimensions and fit tolerances.
    [socket.scad, socket_test.scad]
2026-06-24 test: strengthen socket sizing assert to guard pocket vs outer footprint
    [socket_test.scad]
2026-06-24 feat: swappable flat tape mount_plate (v1)
    Implement mount_plate() module producing a flat tape face matching the body
    footprint. v1 is deliberately swappable (FUTURE(Q6)): once the door-side
    fixing mechanism is confirmed, replace the module body with a brace arm or
    bolt-on shim while keeping the same module name.
    [mount_plate.scad, mount_plate_test.scad]
2026-06-24 feat: monocoque body with component cutouts and mounts
    Adds scad/body.scad (body() + rounded_box()) and test/body_test.scad.
    body() composes outer shell, mount_plate() bottom, pico_w_mounts() bosses,
    sg90_cutout() servo pocket, and USB/LED/button wall openings into a
    manifold open-top enclosure box.
    [body.scad, body_test.scad]
2026-06-24 fix: lay out servo/Pico side-by-side along width, add MOSFET space, extract dims to params
    [body.scad, params.scad]
2026-06-24 fix: move USB opening to Pico's end wall, lift MOSFET keep-out off the floor
    [body.scad]
2026-06-24 docs: correct stale USB wall comment in body.scad
    [body.scad]
2026-06-24 feat: slip-fit lid
    [lid.scad, lid_test.scad]
2026-06-24 feat: top-level assembly, build script, and README
    [smartlock.scad]
2026-06-24 fix: correct README render command, fuse Pico standoffs to floor, params-ize lid dims
    [body.scad, lid.scad, params.scad]
2026-06-24 feat: web STL viewer (Three.js) with Cloudflare quick-tunnel serve script
2026-06-24 feat: rewrite viewer serve as uv run --script (PEP 723) Python
    Replaces serve.sh. devShell is now openscad/uv/cloudflared (drops python3/gh:
    gh is a user-global tool, python3 is provisioned by uv). serve.py renders the
    parts, serves build/, and drives cloudflared for the quick tunnel; stdout is
    line-buffered so the public URL prints immediately.
2026-06-24 feat: add Pico W firmware template (Embassy async + CYW43 WiFi) (#1)
2026-06-24 スマートロック筐体 v2: 実採寸の反映(台形ソケット・本体再レイアウト・座位置決め) (#2)
    [body.scad, lid.scad, mount_plate.scad, params.scad, params_test.scad, socket.scad, socket_test.scad]
2026-06-24 基板の電気設計をコードで定義（ユニバーサル基板手配線用） (#3)
2026-06-25 feat: サーボ PWM 制御（ワンショット駆動・電源ゲート協調・Signal 継ぎ目） (#4)
2026-06-25 refactor: host テスト可能な smtlk-core を分離（ロック制御ロジックの隔離） (#5)
2026-06-25 feat: TCP リスナーをトレイト化し serve ループをモック通しテスト (#6)
    * docs: TCPリスナーのトレイト化とモック通しテストの設計仕様
    * docs: TCPリスナーのトレイト化とモック通しテストの実装プラン
    * feat: smtlk-core に serve_connection（I/O トレイト境界・モック通しテスト）
    * test: serve の CRLF/小文字行テスト追加と重複 import 削除
    * feat: TCP リスナーを配線（SignalSink・serve_connection・デモループ撤去）
    - smtlk-core の embedded-io-a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
2026-06-25 docs: 電子部品のパーツ選定ドキュメント（秋月集約・概算込み） (#8)
    * docs: パーツ選定ドキュメントの設計仕様を追加
    netlist.py の BOM を秋月集約で実商品へ写像し、按分額と実支出の
    両方で概算するドキュメントの構成・選定ルール・完了条件を定義。
    * docs: netlist 非更新の方針と将来フィードバックの申し送りを明記
    netlist.py は今回触らず正として参照のみ。追加5点は回路素子でないため
    netlist に載せず、FET 型番絞り込み/コンデンサ耐圧追記は実機確定後の
    TODO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
2026-06-26 docs: ルート CLAUDE.md を新設（概要 + Claude 向け落とし穴） (#7)
2026-06-26 docs: パーツ選定の通販コードを商品ページへのリンクに (#9)
2026-06-26 feat(scad): SG90 サーボを M2 ねじ固定（床ボス＋タブ逃げ修正） (#10)
    * docs: サーボ SG90 ネジ固定の設計 spec
    * docs: サーボネジ固定の実装プラン＋spec 寸法修正(boss_d 4.5)
    * feat(scad): サーボネジ固定の寸法パラメータと整合 assert を追加
    * feat(scad): servo_mounts() ボス追加とタブ逃げを床側へ移動
    * feat(scad): サーボをボス上に持ち上げ servo_mounts を本体へ配置
    * fix(scad): ボス高さ4.5でM2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
    [body.scad, hardware.scad, params.scad, servo_mount_test.scad]
2026-06-27 ソケット-本体の噛み合わせ修正 + 筐体レイアウト全面見直し (#11)
    * feat(scad): 筐体レイアウト見直し — ソケット内蔵・基板スタッキング対応
    ソケットが本体から浮いていた問題を受けて、ドア断面での積み重なり
    （ノブ→ソケット→SG90→Pico+基板）を設計し直した。
    params.scad:
    - ext_left/right を 27mm に統一（左右対称化、ロゼット Ø46 収容）
    - ext_down を 23mm に拡大（ロゼット下方向の収容）
    - ext_up を 86mm に拡大（Pico + ユニバーサル基板 72mm 収容）
    body.scad:
    - Pico-サーボ間ギャップをロゼット半径から自動算出
    layout_check.s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
    [body.scad, layout_check.scad, lid.scad, mount_plate.scad, params.scad, smartlock.scad, socket.scad]
2026-06-28 spawner.spawn() の括弧位置を修正 + CI 導入 (#35)
    [config.rs]
2026-06-29 fix(scad): mosfet_l/mosfet_w を params.scad に追加し render.sh の誤判定を修正 (#36)
    [params.scad]
2026-06-29 GP16(LED)/GP17(ボタン) 実装 + 二色LED化 (#16, closes #27) (#37)
    * docs: Issue #16 LED/ボタン実装 + 二色LED化の設計 spec
    GP16(LED)/GP17(ボタン)のファーム実装と二色コモンカソードLED化の設計。
    状態を単一ソース化(LOCK_STATE)し STATUS にボタン操作を反映。smtlk-core を
    decide()/LockPort にリファクタして host テスト維持。秋月 OSRGHC5B32A 選定。
    #27(ボタンプルアップ)は内部プルアップ採用で同時クローズ。
    * docs: Issue #16 実装計画（GP16/GP17 + 二色LED）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
    [lib.rs, lock.rs, main.rs]
2026-06-29 fix(circuit): Q1 MOSFET 型番を実購入品 IRLB3813PBF に更新 (closes #17) (#38)
    * docs: Issue #17 MOSFET 型番不一致解消の設計メモ
    netlist.py の Q1 型番を実購入品 IRLB3813PBF へ揃える方針を記録。
    * fix(circuit): Q1 MOSFET 型番を実購入品 IRLB3813PBF に更新 (closes #17)
    netlist.py の PART_META["Q1"] が候補段階の "AO3400 / IRLZ44N" のままで、
    docs/parts-selection.md で確定済みの実購入品 IRLB3813PBF (秋月 I-06270) と
    不一致だった。型番を揃え、gen_bom 整形テストの fixture も同値に更新。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
2026-06-29 fix(scad): USB 開口の Z 位置を Pico W 実装高から導出 (closes #18) (#39)
    * fix(scad): USB 開口の Z 位置を Pico W 実装高から導出 (closes #18)
    body_h*0.4 (≈20.8mm) のヒューリスティック値を
    pico_z + pico_boss_h + pico_h (=5.2mm) に置換し、
    Pico W の USB ポート位置と整合させる。
    * fix(scad): USB カットアウト中心をコネクタ中心に合わせる
    usb_connector_h (2.6mm, 実測) を params.scad に追加し、
    usb_z に usb_connector_h/2 を加算してカットアウト中心を
    USB Micro-B コネクタ中心 (6.5mm) に一致させる。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
    [body.scad, layout_check.scad, params.scad]
2026-06-29 Update inline parameter comments with calculated values (#40)
    [params.scad]
2026-06-30 BOM に M2ネジ・100nFセラコン・1N5819ダイオードを追加 (#21, #25, #26) (#41)
2026-06-30 fix(parts): USB 電源を 5V/3A (M-12001) へ変更しサーボ失速時の不足を解消 (closes #23) (#42)
2026-06-30 ソケットのシャフトボアを十字ホーンポケットに置換 (#22) (#43)
    * docs: C1 ソケットシャフトボア→十字ホーンポケット設計 (#22)
    * docs: スプライン参考値を設計スペックに追記 (#22)
    * docs: 十字ホーンポケット実装プラン (#22)
    * feat(scad): 十字ホーン寸法パラメータを params.scad に追加 (#22)
    SG90 cross horn の主要寸法（腕長・幅、ハブ径、厚さ、ネジ穴、クリアランス）を pa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
    [params.scad, socket.scad]
2026-06-30 docs(parts): MOSFET 3.3V ゲート駆動の根拠を明記し現状維持 (closes #24) (#44)
    * docs(spec): MOSFET 3.3V ゲート駆動の現状維持＋根拠明記 設計 (#24)
    * docs(plan): MOSFET 3.3V ゲート駆動 現状維持の実装プラン (#24)
    * docs(parts): MOSFET 3.3V ゲート駆動の根拠と実機計測基準を明記 (closes #24)
    * docs(parts): MOSFET 根拠の保守見積り根拠と発熱式単位を明確化 (#24)
    * docs(parts): 電圧降下の現実 Rds(on) 想定を明記 (#24)
    * docs(parts): 発熱の現実値併記とロジックレベル根拠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
2026-06-30 fix(firmware): RNG シードを RoscRng で動的生成 (closes #28) (#45)
    * fix(firmware): RNG シードを RoscRng で動的生成し TCP ISN の予測可能性を解消 (closes #28)
    * refactor: rand_core 直接依存を削除し import 順をアルファベット順に修正
    RoscRng は inherent method として next_u64() を持つため
    rand_core::RngCore トレイトの import と直接依存は不要だった。
    ---------
    [main.rs]
2026-07-01 feat(firmware): TCP 接続に per-read アイドルタイムアウトを追加 (closes #30) (#46)
2026-07-01 chore(firmware): embassy-net の未使用 feature (udp, dns) を削除 (closes #31) (#47)
2026-07-01 chore(build): host-test を uname -m でアーキ非依存化 (closes #32) (#48)
    .cargo/config.toml の aarch64 固定 alias を削除し、flake.nix の devShell に
    cargo-host-test 外部サブコマンドを追加。uname -m でホストトリプルを動的解決するため、
    x86_64 / aarch64 どちらの開発環境でも `nix develop -c cargo host-test` がそのまま動く。
2026-07-01 refactor(scad): 未使用の rosette_recess/brace_stub_w を削除 (closes #33) (#49)
    以前のレイアウトから削除されたジオメトリの残留定義を除去した。
    [params.scad]
2026-07-01 refactor(scad): socket_oh を params.scad 単一定義に統一 (closes #34) (#50)
    smartlock.scad のローカル再定義を削除し、socket.scad のローカル変数 oh を params.scad の socket_oh に統一した。
    数値結果は変わらず 18 のまま。
    [smartlock.scad, socket.scad]
2026-07-01 refactor(scad): 未使用モジュール・デッド定義・重複定義を一掃 (#51)
    [hardware.scad, hardware_test.scad, params.scad, servo_mount_test.scad, smartlock.scad]
2026-07-01 feat(scad): ドア採寸とホーン実測を params へ反映＋採寸チェックリスト追加 (#53)
    実機採寸の結果を params.scad に反映し、経緯を docs/measurements-checklist.md に記録。
    ドア側実測:
    - rosette_d 46→45, knob_w_base 28→27.8, knob_w_top 25→25.6, knob_t 3→3.1
    - knob_h 11→30（突き出し大幅増）に伴い pedestal_top_z 23→42 / inner_h 47.1→66.1 / body_h 51.9→70.9 と背高化。連動する計算コメントも更新
    - clear_left 30→50, clear_down 40→65（実測の上限値。実外形は -X 29.4 / -Y 28.4 でずっと内側）
    十字ホーン実測:
    - horn_arm_l を servo_tab_l/2 依存の仮値から独立実測 15.7 へ
    -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
    [params.scad]
2026-07-02 docs(readme): 筐体寄りの README をプロジェクト全体像に再構成 (#54)
    * docs(readme): 筐体寄りの README をプロジェクト全体像に再構成
    タイトルから「筐体」を外し、冒頭にシステム全体像（サブシステム表＋動作フロー）を新設。
    共通の Nix 環境とコマンド早見表を上に集約し、筐体・回路・ファーム・ビューアを対等な
    セクションに並べ替え。既存の詳細手順はすべて該当セクションへ引き継ぎ。
    事実系の追随修正:
    - 実装済みの SG90 PWM 制御を「未確定」から削除（servo.rs に実装済みで本文と矛盾）
    - cyw43-firmware/README.md への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
2026-07-02 feat(scad): ソケットのホーン嵌合を実測補正＋中心突起でブレ止め (#55)
    - horn_arm_l を実測(横腕 全長 33.3mm)基準の 16.65 に補正。旧値 15.7 では
    腕が十字スロットに収まらず外枠を押していた
    - 中心のネジアクセス穴を径 4.6mm・高さ約 0.85mm(ホーン厚の半分)の突起に変更。
    ネジ不使用前提で、ホーン socket 側の中心くぼみに嵌合させ上下左右ズレを止める
    （回り止めは十字キー）
    - 未使用になった horn_screw_d を削除（中心ネジ穴は不使用）
    - 十字スロットがソケット外形(台座クリアランスで 34.9mm 上限)からはみ出さない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
    [params.scad, socket.scad]
2026-07-03 feat(scad): ホーンポケットをテーパー一文字バーに変更＋クーポン追加 (#56)
    * feat(scad): ホーンポケットをテーパー一文字バーに変更＋クーポンパート追加
    十字ポケット→一文字バーに変更し、腕幅を中心→先端の線形テーパー(polygon)で
    再現。実測＋フィット補正で空転を低減する。
    - horn_arm_w → horn_arm_w_base(6.8) / horn_arm_w_tip(3.4) に分離（テーパー）
    - horn_hub_d を 8.0mm に補正（実測6.0+2.0）
    - ポケット形状を polygon + offset(r=hc) + hub circle に変更
    - socket_coupon パート追加（ポケット周辺のみ 4.5mm 厚で迅速フィット確認用）
    - horn_f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
    [params.scad, smartlock.scad, socket.scad]
2026-07-03 feat(scad): サーボ耳マウント再設計＋耳フィット確認用 mount_coupon 追加 (closes #52) (#57)
    * docs(spec): サーボ耳マウント再設計＋耳クーポンの設計書 (#52)
    * docs(plan): サーボ耳マウント再設計＋mount_coupon の実装プラン (#52)
    * feat(scad): 耳ボスを廃止し天板増厚＋貫通下穴で M2 噛み合い 3.5mm を確保 (#52)
    * feat(scad): 耳フィット確認用の mount_coupon パートを追加 (#52)
    * fe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
    [hardware.scad, mount_plate.scad, params.scad, smartlock.scad]
2026-07-03 feat(scad): M2下穴を印刷補正で2.2mmに拡大＋下穴ゲージ pilot_gauge を追加 (#58)
    mount_coupon 印刷で M2 セルフタッピングが下穴（設計1.8）に全く入らなかった。
    A1 mini(0.4ノズル/0.2mm層)では小径縦穴が約0.4mm細く出るため、0.2刻みの
    段階穴ゲージ pilot_gauge.scad を追加して実機で適合径を測定し、2.2 を採用。
    刷り直した mount_coupon で M2 の効きと耳2穴の位置(servo_screw_span=28.5)を
    実機確認できたので、span のコメントを確認済みに更新。
    [params.scad, pilot_gauge.scad]
2026-07-04 実機ファーム書き込みを通す（CYW43 NVRAM 修正＋WiFi環境変数化＋probe-rs/direnv整備） (#60)
    * fix(firmware): CYW43 に NVRAM を渡して WiFi 起動の HT clock ハングを解消
    cyw43 0.7.0 の `new(state, pwr, spi, firmware, nvram)` は 5 番目に NVRAM
    （基板固有のクロック・電源設定）を要求するが、CLM ブロブを渡しており、
    CLM を読む `control.init(clm)` も呼んでいなかった。NVRAM が不正だと起動が
    `waiting for HT clock` で停止する。
    - `nvram_rp2040.bin` を追加取得し `new(.., fw, nvram)` へ渡す
    - CLM は `control.init(clm)` でランナー起動後にロード
    - cyw43-firmware/README を 3 ブロ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
    [config.rs, main.rs]
2026-07-04 feat(scad): USB開口をプラグ基準で12mmに拡大＋床クーポン floor_coupon を追加 (#61)
    実機でロゼット嵌合とドア左/下クリアランスを確認するため、本物の body()
    下部を薄くスライスした floor_coupon パートを追加。ついでに +Y 壁の USB
    開口も含む高さ(wall+8)まで残し、ケーブルプラグの通りも1枚で確認できる。
    USB 開口幅 usb_w を 9 から 12 に拡大。コネクタ本体幅9ではケーブル側の
    プラグ(オーバーモールド)が通らなかった。クリアランス込みで設計開口12.8。
    拡大後のクーポンで実機のプラグが通ることを確認済み。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
    [params.scad, smartlock.scad]
2026-07-04 tscircuit お試し環境（nix+bun）と回路全体シミュレーション (#62)
    * docs(spec): tscircuit お試し環境の設計メモを追加
    * docs(plan): tscircuit お試し環境の実装プランを追加
    * feat(nix): devShell に bun を追加（tscircuit お試し用）
    * feat(tscircuit): bun 管理の tscircuit プロジェクト雛形を追加
    * feat(tscircuit): smtlk 回路を tscircuit で記述（netlist.py と同構成）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
2026-07-05 feat: lockctl.sh と CYW43 ブロブ取得スクリプト fetch.sh を追加 (#64)
    - lockctl.sh: TCP(6000) で LOCK/UNLOCK/STATUS/toggle を送る CLI（bash /dev/tcp、依存なし）。
    ファーム側 TCP サーバは同時1接続しか捌けず、接続を閉じた直後の再接続を RST で蹴るため、
    到達性プリフライトの二重接続はやめて接続を1回だけ張る。
    - crates/firmware/cyw43-firmware/fetch.sh: CYW43439 の firmware/NVRAM/CLM ブロブを
    embassy の固定タグ(cyw43-v0.7.0)から取得。ブロブ本体はライセンス物で .gitignore 済み。
2026-07-05 回路の正を netlist.py から tscircuit へ移行し導通・ショート ERC を追加 (#65)
    * docs: circuit を tscircuit ERC へ移行する設計を追加
    * docs: circuit tscircuit ERC 移行の実装計画を追加
    * refactor(circuit): tscircuit を circuit/ に集約し netlist.py と SPICE デモを削除
    * feat(circuit): 導通・ショート ERC 純関数 runErc を追加
    * feat(circuit): 本番配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
2026-07-05 feat(scad): 電子部品トレイ(Pico W + ユニバーサル基板)を新設 (#59)
    [body.scad, hardware.scad, layout_check.scad, lid.scad, params.scad, smartlock.scad, tray.scad, tray_pilot_gauge.scad]
2026-07-06 回路の共有化リファクタ＋ブレッドボード配線図の自動 place & route (#66)
    * docs: 実装ガイド（配線図）生成の設計を追加
    回路の正(tscircuit)に実物スルーホールのフット＋物理配置を隔離モジュールで
    足し、②tscircuit PCBビュー(build/wiring-pcb.svg)を先に評価、足りなければ
    ①穴グリッド付き自作SVG(build/wiring.svg)を追加する段階方式。
    * docs: 実装ガイド（配線図）生成の実装プランを追加
    parts.ts に部品・結線を共有化→board.tsx(物理)＋placement.ts→②PCBビュー
    build/wiring-pcb.svg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
2026-07-11 ユニバーサル基板を UP-203GSR に変更しトレイのマウントピッチを既製穴(64×39)に合わせる (#68)
    * feat(scad): ユニバーサル基板を UP-203GSR に変更しトレイのマウントピッチを 64×39 に更新
    四隅マウント穴を各外辺から4mm内側に開ける前提へ変更。基板中心と Pico の
    搭載位置は据え置き（uboard_mount_off_x/y は変更なし）で、支柱・トレイ外形・
    本体のネジ逃げが params 追従で内側に寄るのみ。3Dプリント現物合わせで
    tray とのフィットを確認済み。docs/parts-selection.md も UP-203GSR 前提に更新
    （P-03229 は同寸だが工場穴が合わないため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
    [params.scad]
2026-07-12 feat(circuit): ブレッドボード配線図ビューアを clean 移植 (#70) (#71)
    * docs: ブレッドボード方針転換の設計 spec 2本を追加(ビューア移植/筐体+トレイ)
    perfboard→ブレッドボード方針転換に伴う 2 ワークストリームの設計を確定:
    - A: ビューア clean 移植(issue #70) — perfboard 抜き 3ファイル+README
    - B: 筐体拡大+ブレッドボードトレイ新設 — Pico 据置/BB を +X 横付け(縦長)
    perfboard はパーク保存(feat/perfboard-wiring-diagram tip 507f7e9)。
    * feat(circuit): ブレッドボード配線図ビューアを clean 移植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
2026-07-14 feat(scad): 筐体拡大＋ブレッドボードトレイ作り替え（workstream B） (#73)
    * docs(plan): 筐体拡大＋ブレッドボードトレイ workstream B の実装プランを追加
    * feat(scad): 筐体を +X/+Y へ拡大しブレッドボード配置・固定ポスト定数へ差し替え
    * feat(scad): トレイを Pico+ブレッドボード横並び（囲い壁ポケット＋固定ポスト＋爪）へ全面書き換え
    params は OpenSCAD の前方参照不可に合わせ extents→Pico配置→BB→トレイの依存順へ整列
    Co-A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
    [body.scad, hardware.scad, layout_check.scad, mount_plate.scad, params.scad, smartlock.scad, tray.scad, tray_pilot_gauge.scad]
2026-07-17 筐体をオープンベースプレート化：トレイ・ペデスタルを天面ネジのボルトオンに (#74)
    * docs(spec): トレイ天面留め（本体裏留めの廃止）設計書
    * docs(plan): トレイ天面留め 実装プラン
    * feat(scad): トレイ固定を本体裏留めから天面留め（ボス＋スリーブ）へ
    * feat(scad): ボス⇔スリーブ嵌合クーポン part を追加
    * docs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
    [body.scad, clash_check.scad, hardware.scad, hardware_test.scad, layout_check.scad, lid.scad, lid_test.scad, mount_plate.scad]
2026-07-17 calib(servo): UNLOCK_DEG を 90°→150° に（実機で解錠位置に到達） (#75)
    サムターン解錠に必要な回転量が 90°(1500µs) では約半分しか出ず、実機で
    段階的に確認して 150°(1833µs) で解錠位置に到達することを確認した。
    SG90 個体の実可動域が狭いパルス窓(1000–2000µs)の想定と食い違うため、
    角度→パルス変換の窓は据え置き、UNLOCK_DEG のみ実測で合わせる。
    servo_math のパルス幅テスト期待値も 1500→1833µs へ更新。
2026-07-19 ソケット v2: キャプチャ壁＋押さえ爪＋面ファスナー厚の Z 補正（実機動作確認済み） (closes #77) (#78)
    * docs(spec): ソケット v2 キャプチャ壁＋マウントパッド Z 補正の設計 (#77)
    * feat(scad): ホーン固定検討のクーポン 2 種（スプライン歯形ゲージ・スナップ爪）
    - spline_gauge: ホーンレス直嵌合の下穴ゲージ。v4 で burariweb の 21 歯
    離散三角形レシピ（基準円 5.25/辺 0.51）を移植。実機方針転換で棚上げだが
    歯形レシピの記録として残す
    - horn_snap_coupon: スナップ爪の試験片。ナイフエ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
    [horn_snap_coupon.scad, params.scad, smartlock.scad, socket.scad, spline_gauge.scad]
2026-07-20 プロジェクト整理: bun ツーリング統一・README/docs 再編・Backlog.md 移行 (#79)
    * docs(spec): プロジェクト整理（komorebi 流ツーリング統一＋ドキュメント再編）の設計
    * docs(plan): プロジェクト整理の実装計画（bun ツーリング統一＋ドキュメント再編、全11タスク）
    * feat(scad): openscad 呼び出しの bun 共通ヘルパを追加（komorebi 移植＋PNG/clash 対応）
    * feat(scad): 筐体ビルドを bun scad/build.ts へ移行し build.sh を廃止（出力先 scad/build/）
    * feat(scad): 単発レ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
    [body_test.scad, clash_check.scad, hardware_test.scad, params.scad, params_test.scad, pedestal_test.scad, socket_test.scad]
2026-07-20 Rust edition 2024 移行 + [workspace.package] でメタデータ共有 (closes TASK-11) (#82)
    - 両クレートを edition 2024 へ、workspace を resolver "3" へ移行（unsafe/static mut 無しでソース手直しゼロ）
    - version/edition/rust-version(1.96)/license を [workspace.package] に集約し member は *.workspace = true で参照
    - host-test 20/20、check×2・clippy×2(-D warnings) クリーン、Cargo.lock 差分なし
2026-07-20 TASK-10 WebUI: yew SPA を Pico W から picoserve で HTTP 配信（生 TCP 廃止） (#83)
    * docs(spec): TASK-10 WebUI 設計（yew SPA を Pico W から picoserve で HTTP 配信）
    生 TCP(6000) を廃し HTTP 一本化。yew(WASM) を firmware に埋め込み、
    picoserve で SPA＋JSON API を配信。lockctl.ts も fetch に移行。
    状態の単一ソース（LOCK_STATE/apply_target）とサーボ/ボタン/LED は不変。
    * docs(plan): TASK-10 WebUI 実装プラン（7タスク・TDD・picoserve 互換スパイク付き）
    * feat(core): HTTP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
2026-07-21 calib(pedestal): 高さを実機確認済みの 46mm へ戻す（v2 面ファスナー補正を撤回） (#84)
    面ファスナー厚ぶんの v2 主補正 (-mount_pad_t, 6mm) は実機で過補正と判明。
    撤回してローカル造形高さ 46mm (pedestal_top_z=48.4) へ戻す。
    [params.scad]
2026-07-21 cargo workspace 統合 + rust-overlay 導入 + API 型共有 (closes TASK-9, TASK-12, TASK-13) (#85)
    * cargo workspace 統合: crates/* 一律メンバ化 + rust-overlay 導入 (closes TASK-9, TASK-12)
    - members = ["crates/*"] + default-members で webui(wasm32) をメンバ化しつつ
    素の cargo build(thumbv6m) から分離。exclude と webui の空 [workspace] を撤去
    - webui の release プロファイルをルートへ移設、Cargo.lock をルートに統合
    - flake.nix: rustup → rust-overlay (fromRustupToolchainFile)。cargo が実バイナリになり
    RUSTUP_TOOLCHAIN 環境変数の干渉 (env -u が必要だった問題) を解消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
2026-07-21 ディレクトリ再編（scad → enclosure）と Justfile 導入 (#86)
    [body.scad, body_test.scad, clash_check.scad, hardware.scad, hardware_test.scad, horn_snap_coupon.scad, params.scad, params_test.scad]
2026-07-22 TASK-14 遠隔操作: Cloudflare Tunnel + Access と home-manager モジュール化した中継スタック (#87)
    * brainstorm(remote): インターネット越し鍵操作を Cloudflare Tunnel + Access で設計
    * backlog: TASK-14 遠隔操作(Cloudflare Tunnel + Access)を追加
    * spec/backlog: 遠隔操作の確定値(door-lock.private.ekuinox.dev/172.20.10.13/Google)と可変IP運用を反映
    * spec/backlog: ホスト名を door-lock-private.ekuinox.dev(1段)に変更 + Universal SSL 制約を記録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
2026-07-26 解錠後オートロック: AUTO_LOCK_AFTER で自動施錠 (#88)
    * docs(spec): 解錠後オートロック（config Duration 指定）の設計
    * docs(plan): 解錠後オートロックの実装プラン
    * feat(firmware): オートロック待ち時間 AUTO_LOCK_AFTER を config に追加
    * feat(firmware): 解錠後 AUTO_LOCK_AFTER で自動施錠する auto_lock_task を追加
    * docs(firmware): AUTO_LOCK_AFTER に near-zero 回避の注記を戻す
    ---------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
2026-08-16 TASK-15 OTA アップデート: embassy-boot A/B パーティションで LAN 内からファーム更新 (#89)
    * TASK-15 起票 + OTA (embassy-boot A/B) 設計ドキュメント
    * OTA 実装プラン（設計サイズ実測反映込み）
    * mube-core: OTA 転送プロトコルの純ロジック（ヘッダ・CRC32・受信管理）
    * firmware: /api/version 追加（git describe をビルド時埋め込み）
    * mube-boot: embassy-boot ブートローダー追加、フ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
2026-08-23 筐体: ユニバーサル基板化と全体カバーの新設 (#90)
    * docs: ユニバーサル基板化＋全体カバーの設計書を追加
    ブレッドボードから P-03229 への移行、プレート外形の縮小、
    一体スロープ型カバーとボタンキャップの新設までを設計。
    * docs: カバーのボタンキャップを廃止し LED/スイッチを素通し穴に
    タクトスイッチは屋根の φ12 穴から直接押す。印刷部品は 5 点に戻る。
    * docs: スイッチをパネル取付の PS21B-1 に変更しカバー側部品へ
    基板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
    [body.scad, body_test.scad, clash_check.scad, cover.scad, cover_test.scad, hardware.scad, hardware_test.scad, params.scad]
